yukari502/Pico-Magnetic-MidiKeyboard/PCB&Schematic&BOM/BOM_Midi Keyboard Mian Board_Schematic.xlsx

No. | Quantity | Comment | Designator | Footprint | Value | Manufacturer Part | Manufacturer | Supplier Part | Supplier | Unique ID | Name | Device | LCSC Part Name
1 | 1 | 10nF | C1 | C0805 | 10nF | CL21B103KBANNNC | SAMSUNG(三星) | C1710 | LCSC | gge6 | 10nF | CL21B103KBANNNC | 10nF ±10% 50V
2 | 1 | 100nF | C2 | C0603 | 100nF | CGA0603X7R104K500JT | HRE(芯声) | C6119867 | LCSC | gge30 | 100nF | CGA0603X7R104K500JT | 100nF ±10% 50V
3 | 1 | 10uF | C3 | CAP-SMD_BD5.0-L5.3-W5.3-LS6.0-FD | 10uF | JVJ50v10M5x5 | JIERR(捷而瑞) | C46550416 | LCSC | gge31 | 10uF | JVJ50v10M5x5 | 10uF ±20% 50V
4 | 5 | NCD0603Y2 | LED0,LED1,LED2,LED3,LED4 | LED0603-RD |  | NCD0603Y2 | 国星光电 | C89811 | LCSC | gge4,gge19,gge20,gge21,gge22 | NCD0603Y2 | NCD0603Y2 | NCD0603Y2
5 | 1 | 1kΩ | R1 | R0603 | 1kΩ | 0603WAF1001T5E | UNI-ROYAL(厚声) | C21190 | LCSC | gge5 | 1kΩ | 0603WAF1001T5E | 1kΩ ±1% 100mW 厚膜电阻
6 | 5 | 150Ω | R2,R3,R4,R5,R6 | R0603 | 150Ω | 0603WAF1500T5E | UNI-ROYAL(厚声) | C22808 | LCSC | gge23,gge24,gge25,gge26,gge27 | 150Ω | 0603WAF1500T5E | 150Ω ±1% 100mW 厚膜电阻
7 | 1 | PICO | U1 | COMM-SMD_L51.0-W21.0-P2.54_SC0916 |  | PICO | Raspberry Pi(树莓派) | C7203002 | LCSC | gge1 | PICO | PICO | PICO
8 | 1 | CD74HC4067M96 | U2 | SOIC-24_L15.4-W7.5-P1.27-LS10.3-BL |  | CD74HC4067M96 | TI(德州仪器) | C496123 | LCSC | gge2 | CD74HC4067M96 | CD74HC4067M96 | 高速CMOS逻辑16通道模拟多路复用器/解复用器
9 | 1 | C | U3 | SOT-23-3_L2.9-W1.3-P1.90-LS2.4-BR-CW |  | HAL403SO | Hallwee(霍尔微电子) | C42387470 | LCSC | gge3 | HAL403SO | HAL403SO | HAL403SO
22 | 2 | MX-1U | U16,U17 | CHERRY MX 1U |  |  |  |  |  | gge32,gge33 | MX-1U | MX-1U
