yukari502/Pico-Magnetic-MidiKeyboard/REF/引脚信息对照表.xlsx

Pico 引脚号 (物理) | GPIO 编号 (代码用) | 连接对象 (网络名称/元件) | 作用与备注 | Mux 引脚号 | 引脚名称 | 连接对象 | 作用与备注
Pin 1 | GP0 | Mux S0 (Pin 10) | 地址线 A (二进制位 0) | Pin 1 | COMMON (SIG) | Pico GP26 (Pin 31) | 总信号输出。经过 1kΩ 电阻，且对地并联 10nF 电容
Pin 2 | GP1 | Mux S1 (Pin 11) | 地址线 B (二进制位 1) | Pin 24 | VCC | Pico 3V3 | 电源。注意： 旁边紧贴并联 100nF 和 10uF 电容
Pin 4 | GP2 | Mux S2 (Pin 14) | 地址线 C (二进制位 2) | Pin 12 | GND | GND | 接地
Pin 5 | GP3 | Mux S3 (Pin 13) | 地址线 D (二进制位 3) | Pin 15 | E# (Enable) | GND | 使能端。必须接地芯片才工作 (低电平有效)
Pin 14 | GP10 | LED 1 (黄色) | 八度指示 (C2)，需串联 150Ω 电阻 | Pin 10 | S0 | Pico GP0 | 地址控制线 0
Pin 15 | GP11 | LED 2 (黄色) | 八度指示 (C3)，需串联 150Ω 电阻 | Pin 11 | S1 | Pico GP1 | 地址控制线 1
Pin 16 | GP12 | LED 3 (黄色) | 八度指示 (C4)，需串联 150Ω 电阻 | Pin 14 | S2 | Pico GP2 | 地址控制线 2
Pin 17 | GP13 | LED 4 (黄色) | 八度指示 (C5)，需串联 150Ω 电阻 | Pin 13 | S3 | Pico GP3 | 地址控制线 3
Pin 19 | GP14 | LED 5 (黄色) | 八度指示 (C6)，需串联 150Ω 电阻 | Pin 9 | I0 | 传感器 1 (C) | 音符 C (低音)
Pin 20 | GP15 | 按钮 1 (Switch) | 八度下调 (Down)，没有使用上拉电阻，代码需设为 INPUT_PULLUP | Pin 8 | I1 | 传感器 2 (C#) | 音符 C#
Pin 21 | GP16 | 按钮 2 (Switch) | 八度上调 (Up)，没有使用上拉电阻，代码需设为 INPUT_PULLUP | Pin 7 | I2 | 传感器 3 (D) | 音符 D
Pin 31 | GP26 (ADC0) | Mux COM (Pin 1) | 模拟信号输入。注意： 必须经过 RC 滤波器 (1kΩ/10nF) | Pin 6 | I3 | 传感器 4 (D#) | 音符 D#
Pin 36 | 3V3(OUT) | 全局 3.3V 电源线 | 供电核心。连接到 Mux 和所有传感器的 VCC | Pin 5 | I4 | 传感器 5 (E) | 音符 E
Pin 38 | GND | 全局 GND | 公共地。连接到所有元件的 GND | Pin 4 | I5 | 传感器 6 (F) | 音符 F
Pin 40 | VBUS | USB 接口 5V | 不使用 | Pin 3 | I6 | 传感器 7 (F#) | 音符 F#
 |  |  |  | Pin 2 | I7 | 传感器 8 (G) | 音符 G
 |  |  |  | Pin 23 | I8 | 传感器 9 (G#) | 音符 G#
传感器引脚 (通常顺序) | 名称 | 连接对象 | 作用 | Pin 22 | I9 | 传感器 10 (A) | 音符 A
Pin 1 (正面左) | VCC | Pico 3V3 | 供电 | Pin 21 | I10 | 传感器 11 (A#) | 音符 A#
Pin 2 (正面中) | GND | GND | 接地 | Pin 20 | I11 | 传感器 12 (B) | 音符 B
Pin 3 (正面右) | OUT | Mux 的 Ix 引脚 | 输出模拟电压信号 (对应具体的音符) | Pin 19 | I12 | 传感器 13 (C+1) | 音符 C (高八度)
 |  |  |  | Pin 18 | I13 | GND | 闲置通道 - 必须接地 (防止噪声)
 |  |  |  | Pin 17 | I14 | GND | 闲置通道 - 必须接地
 |  |  |  | Pin 16 | I15 | GND | 闲置通道 - 必须接地
