yukari502/Pico-Magnetic-MidiKeyboard/(list of files, drawings)

Other design files:
PCB&Schematic&BOM/Midi Keyboard Mian Board/Schematic1/P1.schdoc
PCB&Schematic&BOM/PCB_Left.pcbdoc
PCB&Schematic&BOM/PCB_Right.pcbdoc
